Rustimation/Pylontech-Battery-Monitoring/(commit log)

2024-01-16 Schematic for Add-On Piggyback Board
2024-01-17 Schematics for console and wakeup on a single board.
2024-01-17 Schematics for all in one board
2024-12-12 New version to reflect changed output of pwr command
    Includes additional feature for display of crucial battery info (V, SoC, Status) on a little SSD1306 OLED Display
2025-02-15 Update 241211_Github_Pylon_Display_Wakeup_NewStructure.ino
    error correction - missing output definition for Wakeup Pin
    [241211_Github_Pylon_Display_Wakeup_NewStructure.ino]
